adafruit/Adafruit-LSM303-PCB/Adafruit_LSM303DLHC.brd

## EAGLE design Adafruit_LSM303DLHC.brd (2013-06-19)

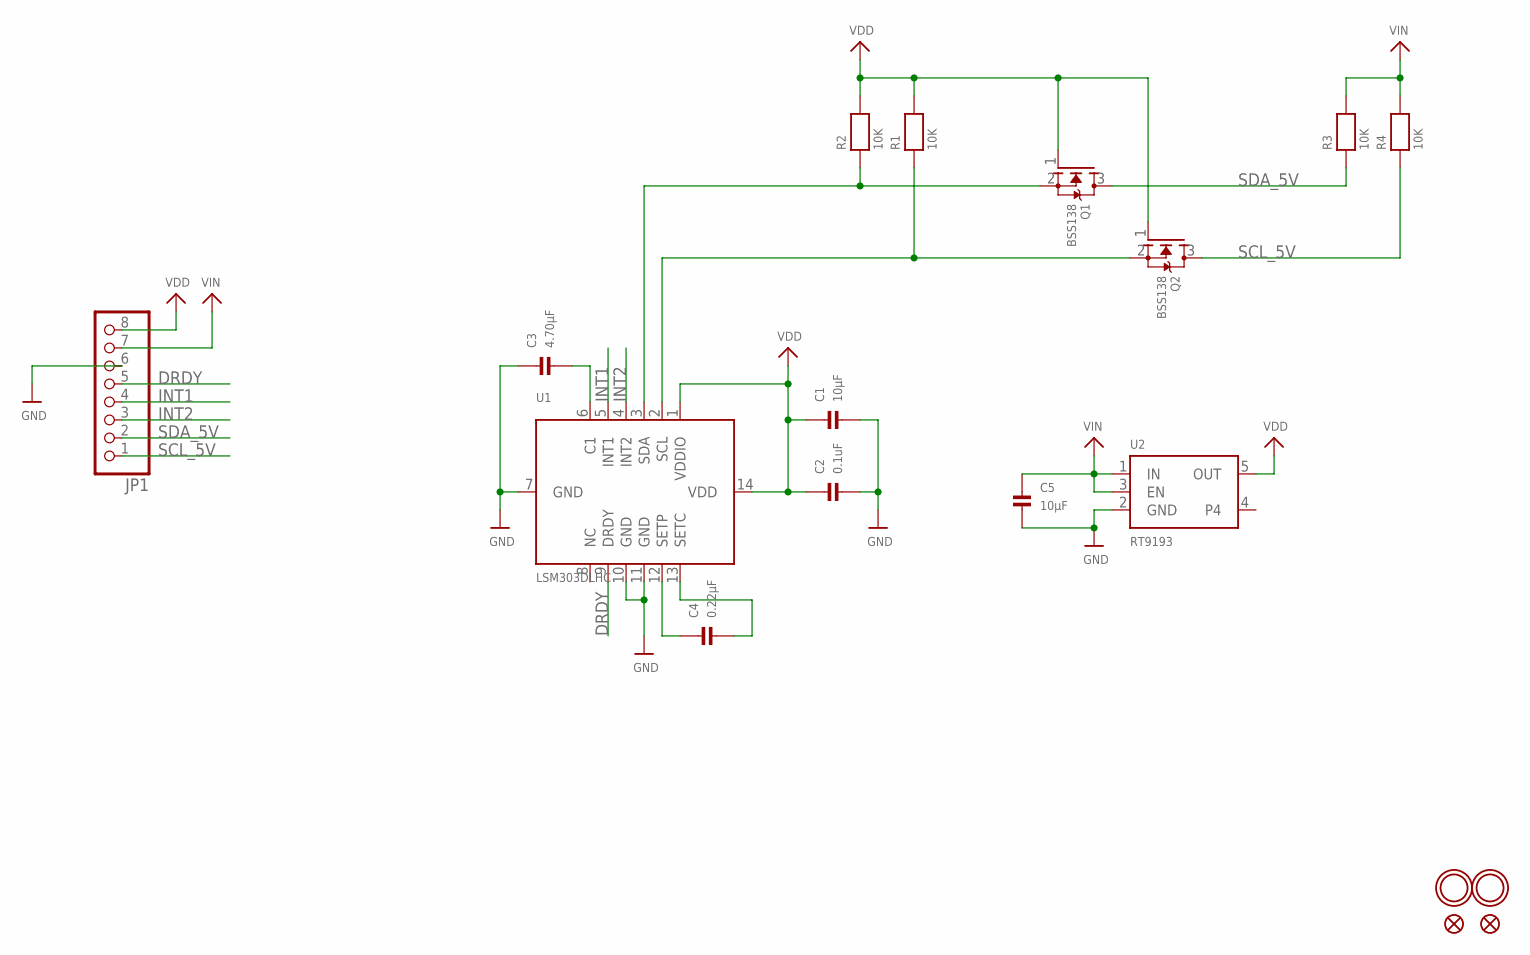
[picture p2: schematic Adafruit_LSM303DLHC.sch]

Parts:
C1, C5: 10µF; _0805
C2: 0.1uF; _0805
C3: 4.70µF; _0805
C4: 0.22µF; _0805
FID1, FID2: FIDUCIAL""; FIDUCIAL_1MM
JP1: HEADER-1X876MIL; 1X08_ROUND_76
Q1, Q2: BSS138; SOT23-WIDE
R1, R2, R3, R4: 10K; _0805
U1: LSM303DLHC; LGA14
U2: RT9193; SOT23-5
U$3, U$4: MOUNTINGHOLE2.5; MOUNTINGHOLE_2.5_PLATED

Connections:
DRDY: JP1.5, U1.9 (DRDY)
GND: C1.2, C2.2, C3.1, C5.2, JP1.6, U1.7 (GND), U1.10 (GND), U1.11 (GND), U2.2 (GND)
INT1: JP1.4, U1.5 (INT1)
INT2: JP1.3, U1.4 (INT2)
unnamed: Q1.2 (S), R2.1, U1.3 (SDA)
unnamed: Q2.2 (S), R1.1, U1.2 (SCL)
unnamed: C3.2, U1.6 (C1)
unnamed: C4.1, U1.12 (SETP)
unnamed: C4.2, U1.13 (SETC)
SCL_5V: JP1.1, Q2.3 (D), R4.1
SDA_5V: JP1.2, Q1.3 (D), R3.1
VDD: C1.1, C2.1, JP1.8, Q1.1 (G), Q2.1 (G), R1.2, R2.2, U1.1 (VDDIO), U1.14 (VDD), U2.5 (OUT)
VIN: C5.1, JP1.7, R3.2, R4.2, U2.1 (IN), U2.3 (EN)

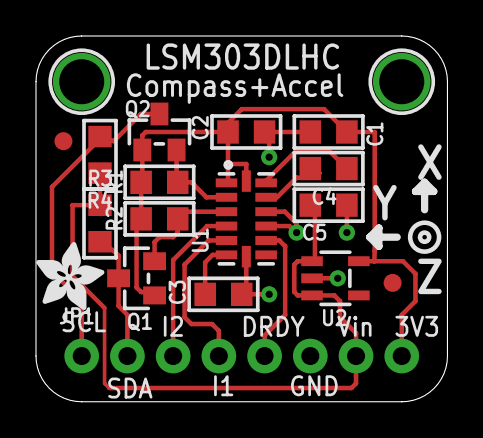
[picture p3: board Adafruit_LSM303DLHC.brd from above]

Board: 2 copper layers, 22.9 x 20.3 mm, 19 parts (0 on the bottom side), 13 nets.

Other parts of the board:
U$17: ADAFRUIT_3.5MM
